DB375237/salvaduino/documents/solenoid-lock.png

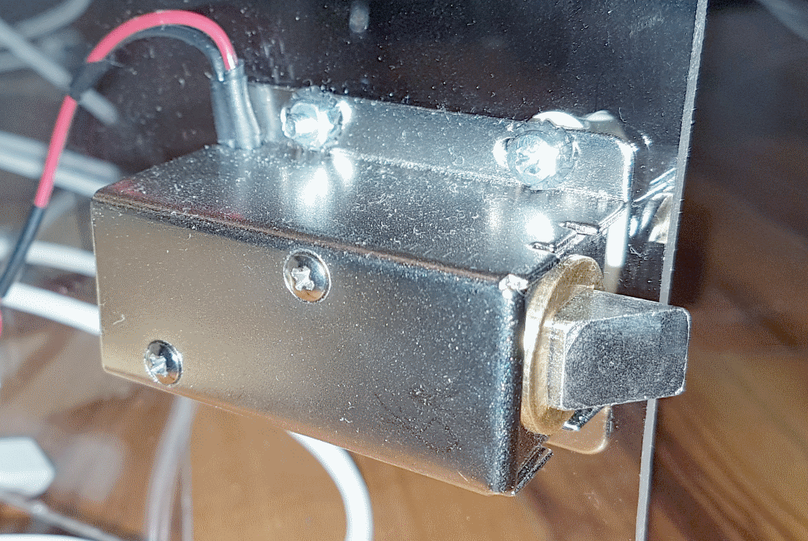
documents/solenoid-lock.png
