DB375237/salvaduino/documents/LCD.png

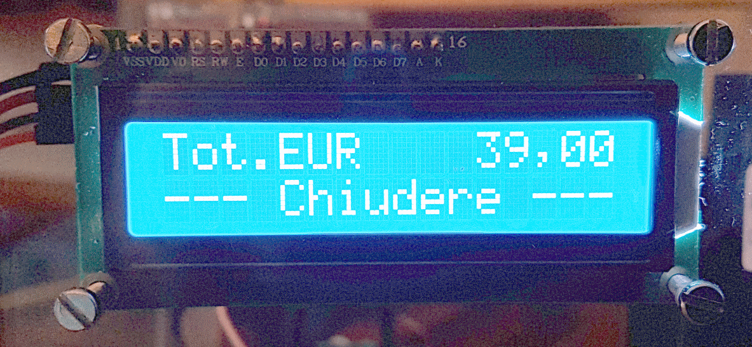
documents/LCD.png
