DB375237/salvaduino/documents/arduino.png

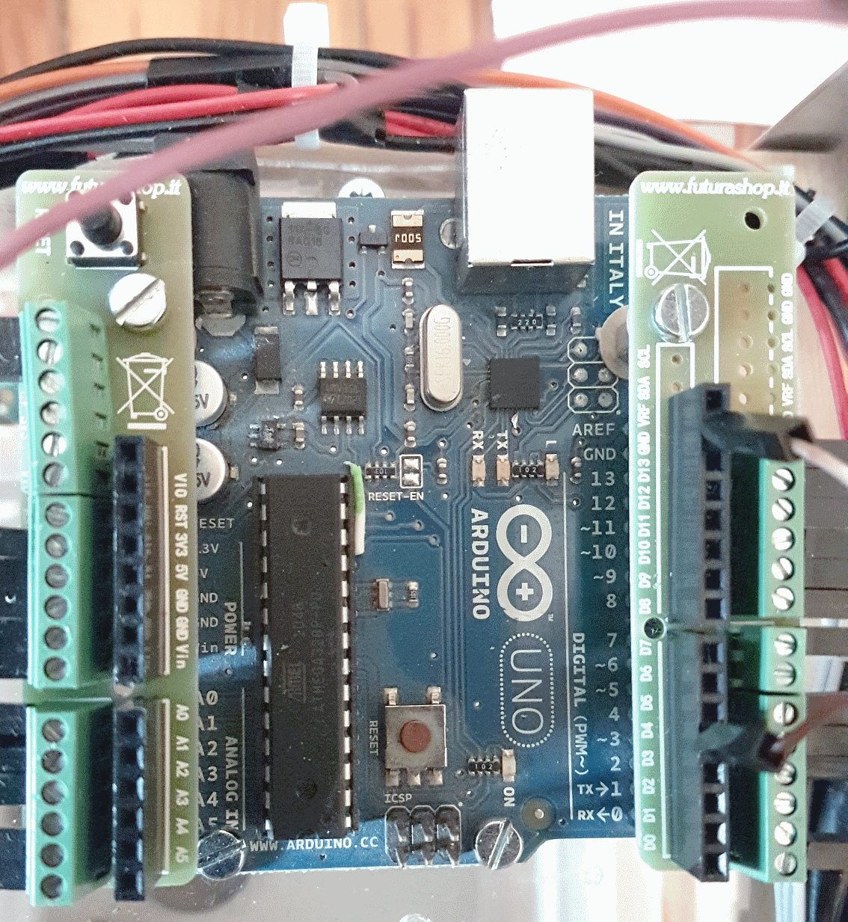
documents/arduino.png
