DB375237/salvaduino/documents/HC-SR04-2.png

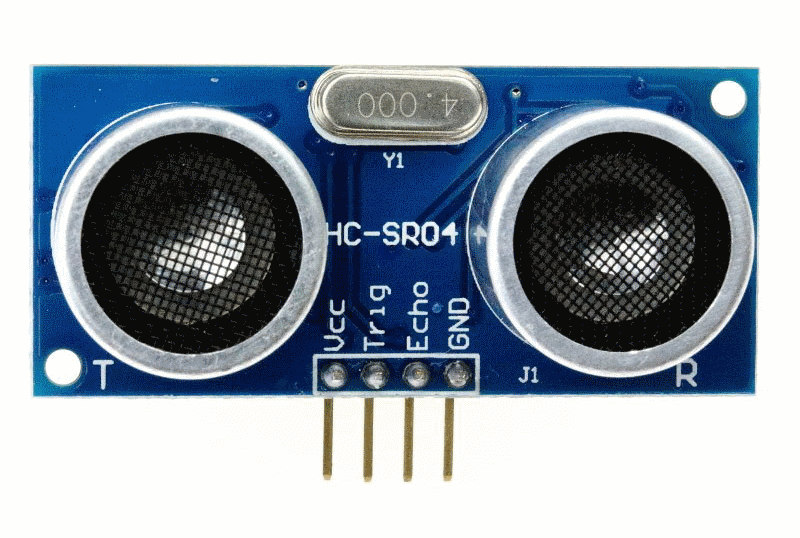
documents/HC-SR04-2.png
