DB375237/salvaduino/documents/HC-SR04.png

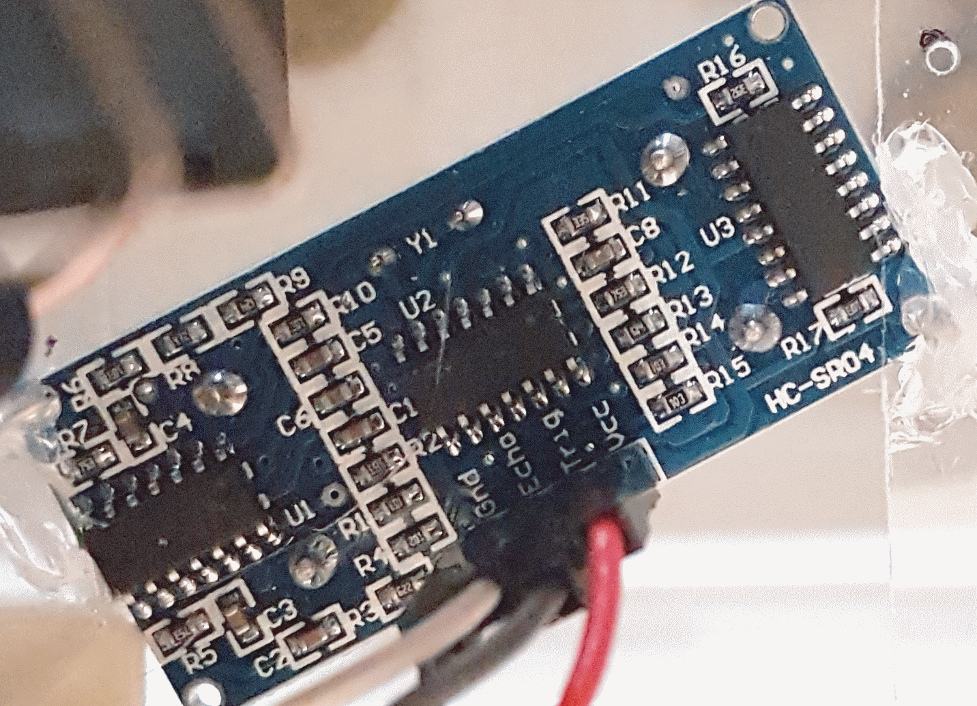
documents/HC-SR04.png
