DB375237/salvaduino/documents/I2C-backpack.png

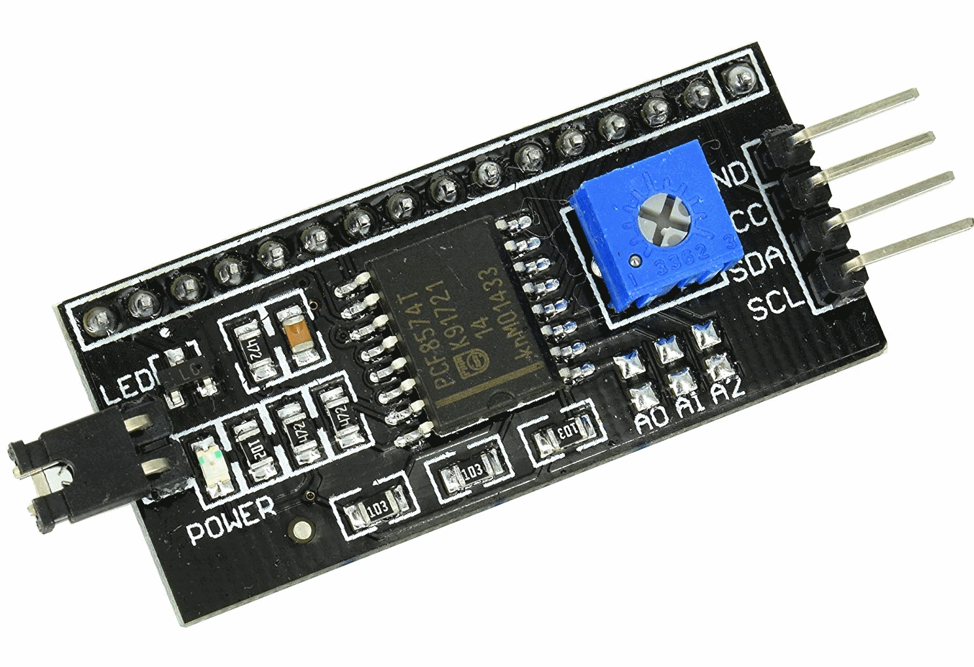
documents/I2C-backpack.png
