DB375237/salvaduino/documents/rfid.png

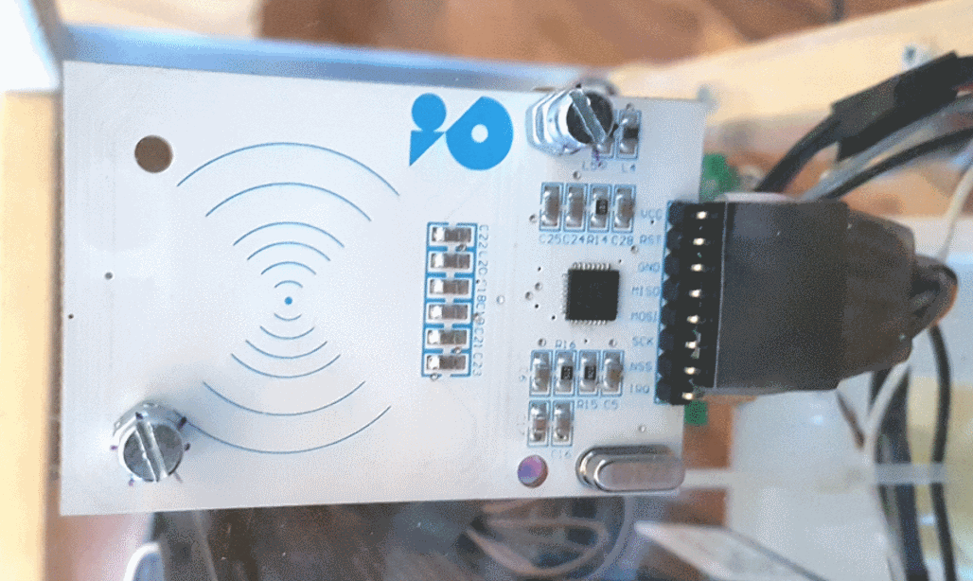
documents/rfid.png
