DB375237/salvaduino/documents/salvaduino-12-5-schematic.png

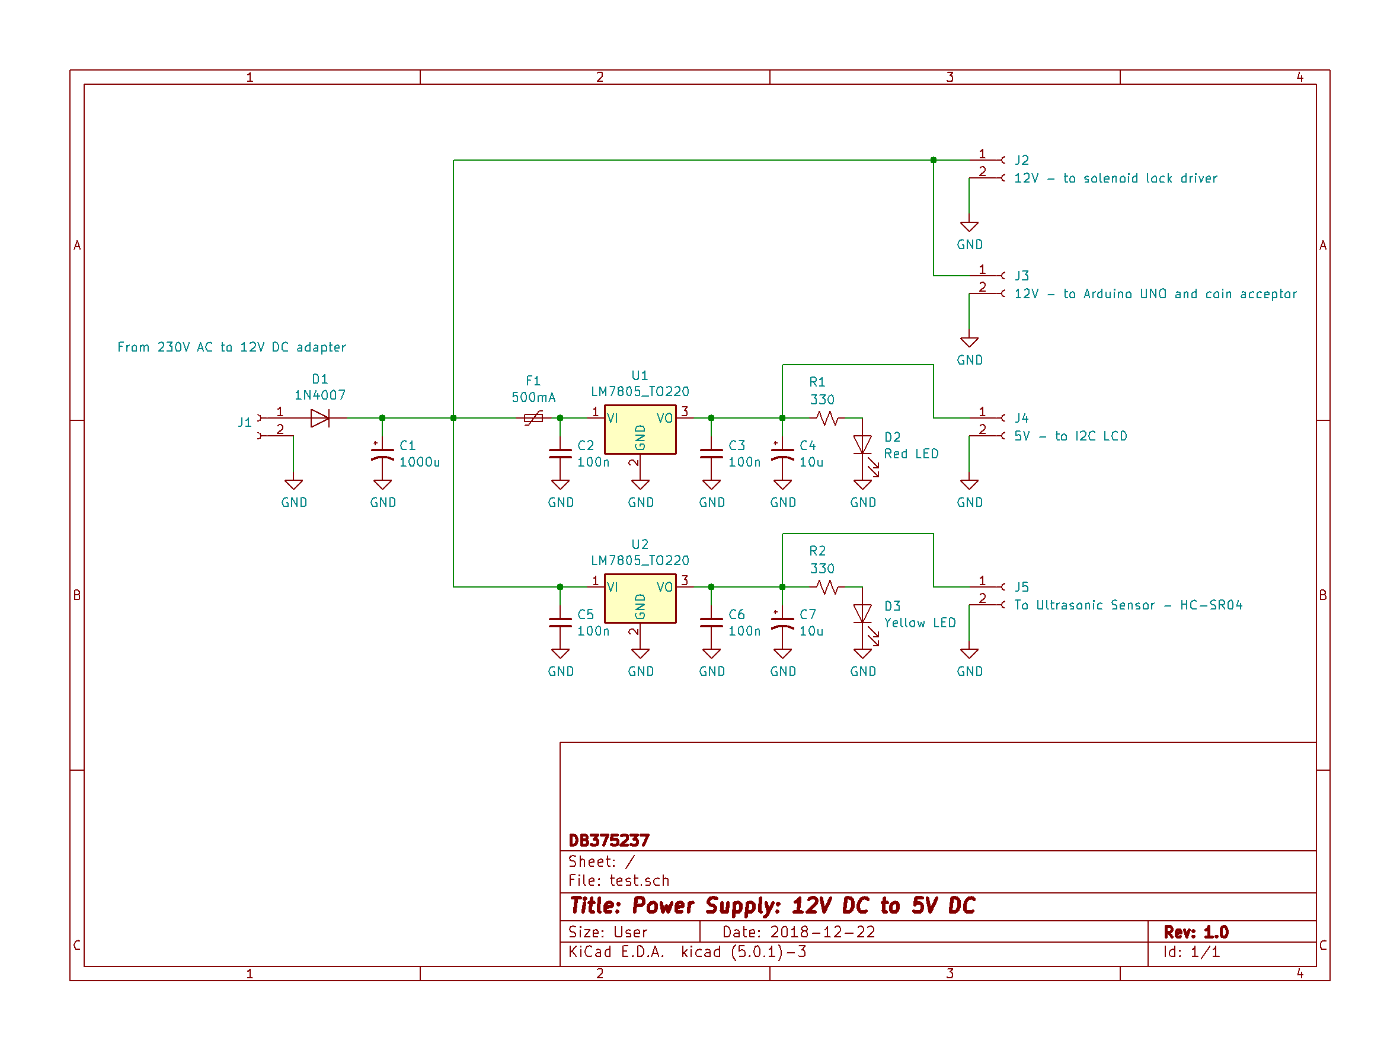
documents/salvaduino-12-5-schematic.png
