DB375237/salvaduino/documents/salvaduino-block-diagram.png

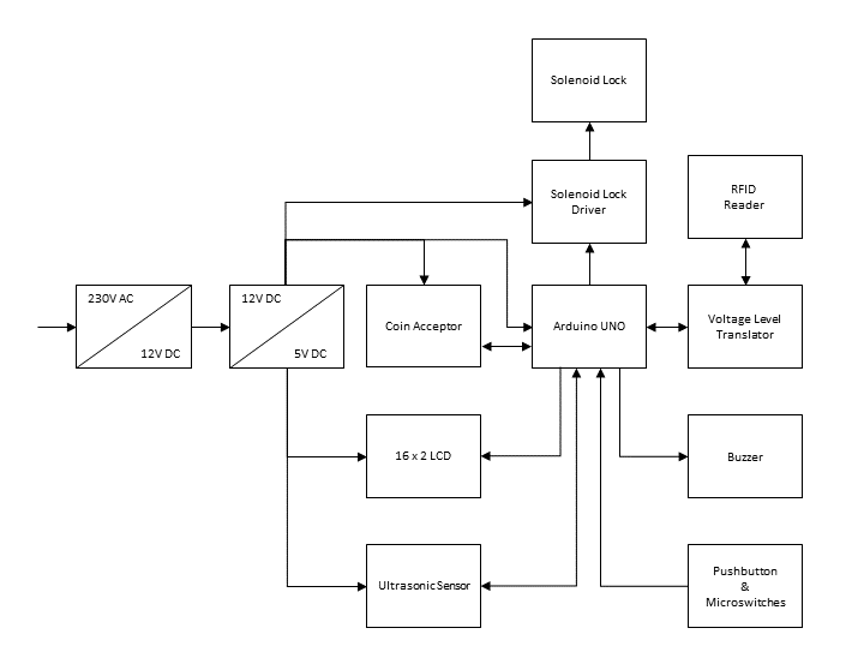
documents/salvaduino-block-diagram.png
