DB375237/salvaduino/documents/salvaduino-other-peripherals.png

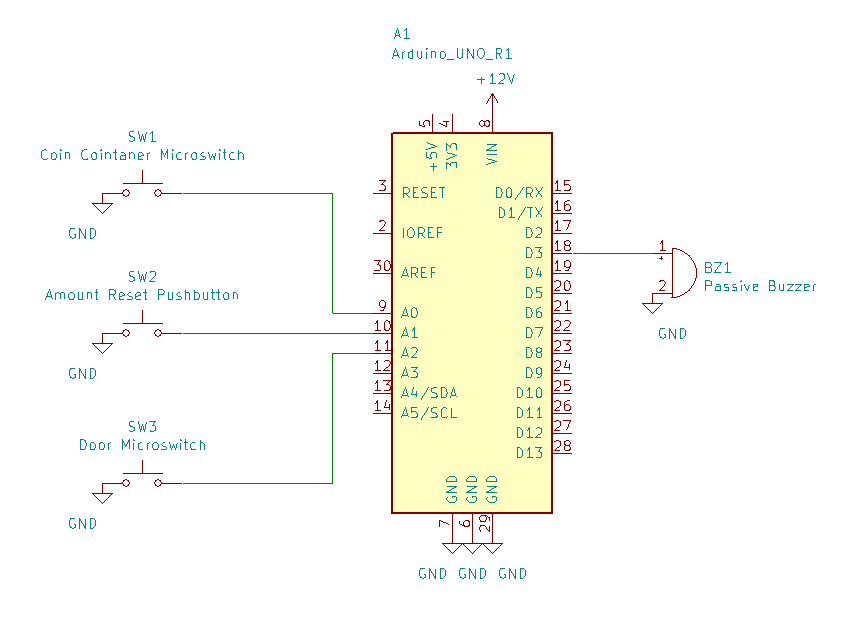
documents/salvaduino-other-peripherals.png
