DB375237/salvaduino/documents/salvaduino-rfid.png

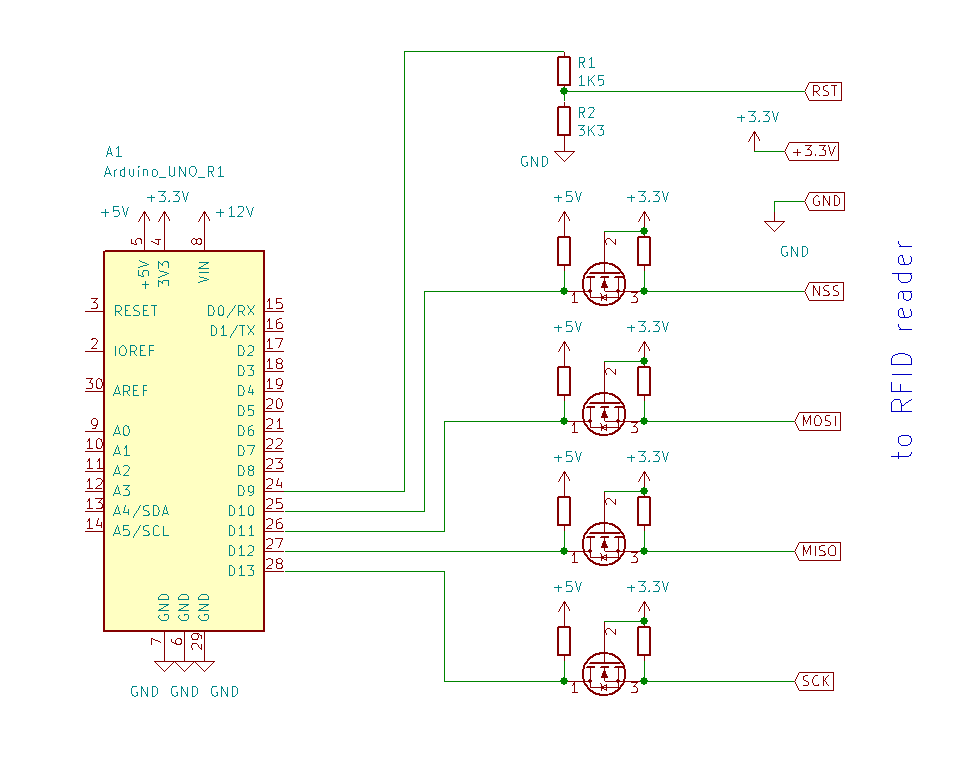
documents/salvaduino-rfid.png
