DB375237/salvaduino/documents/salvaduino-solenoid-driver-schematic.png

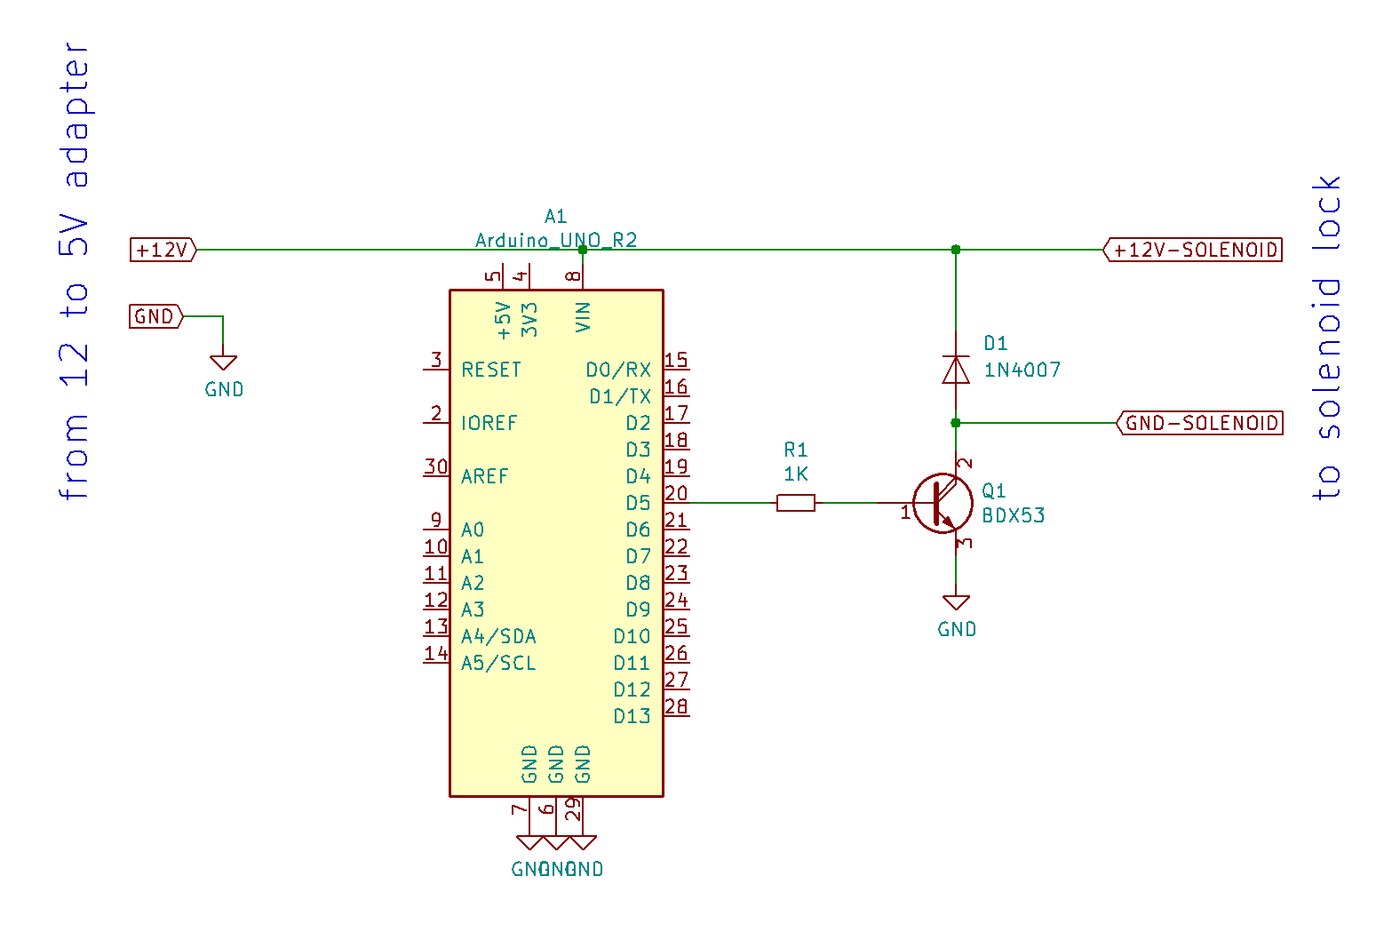
documents/salvaduino-solenoid-driver-schematic.png
