DB375237/salvaduino/documents/salvaduino-state.png

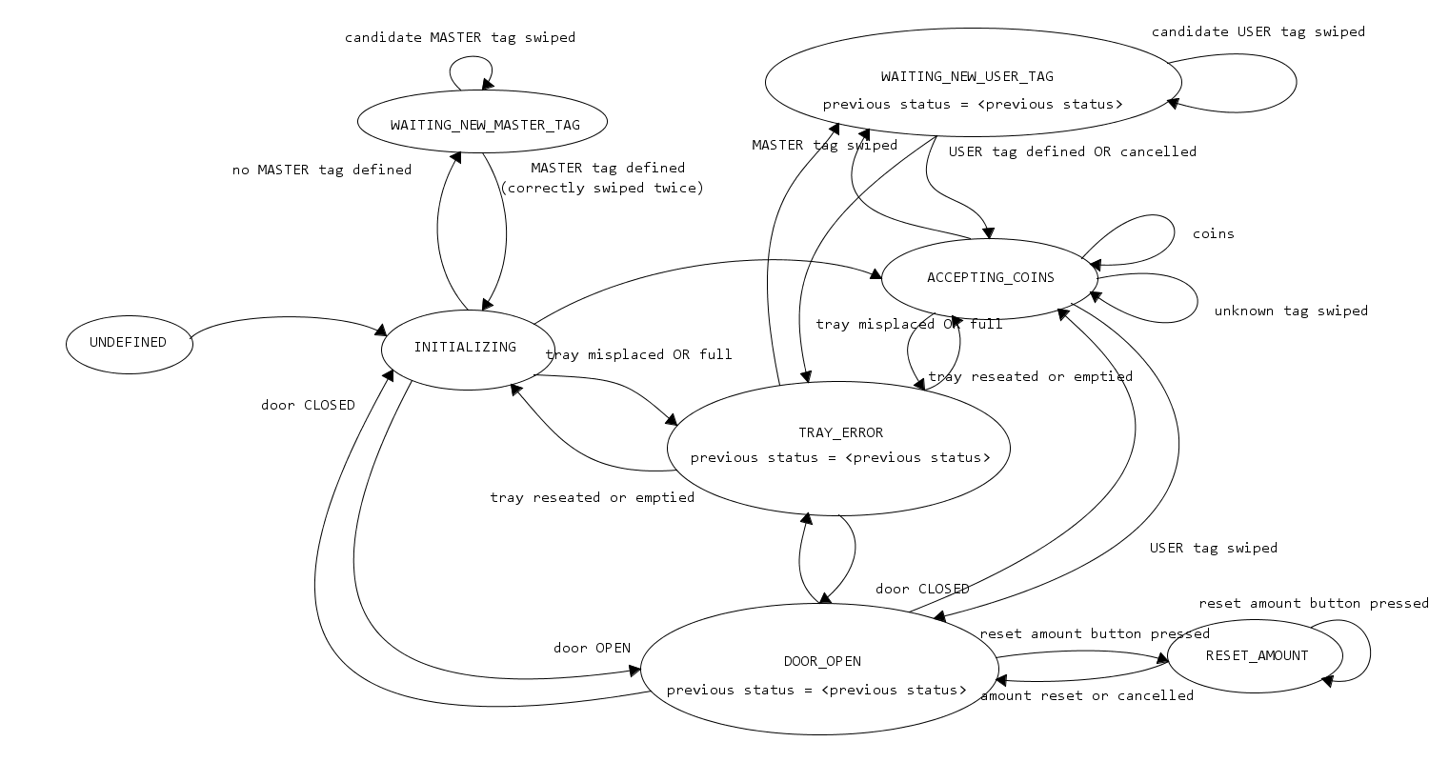
documents/salvaduino-state.png
