DB375237/salvaduino/documents/salvaduino.png

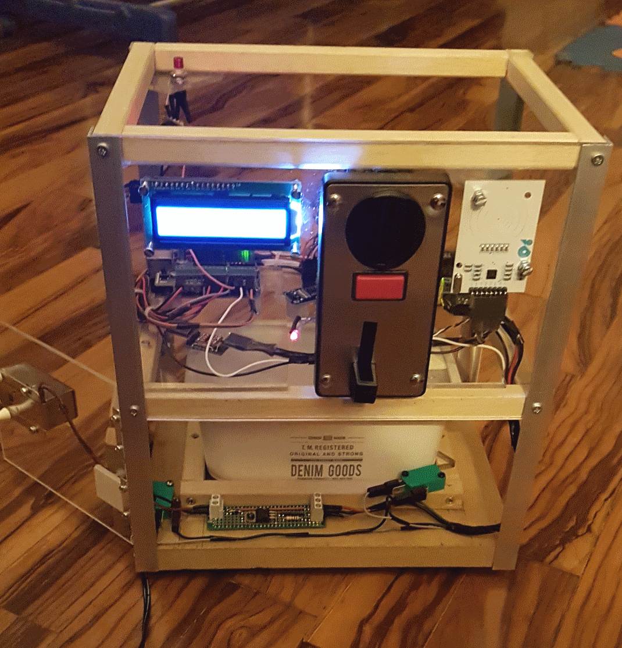
documents/salvaduino.png
