DB375237/salvaduino/documents/solenoid-lock-driver.png

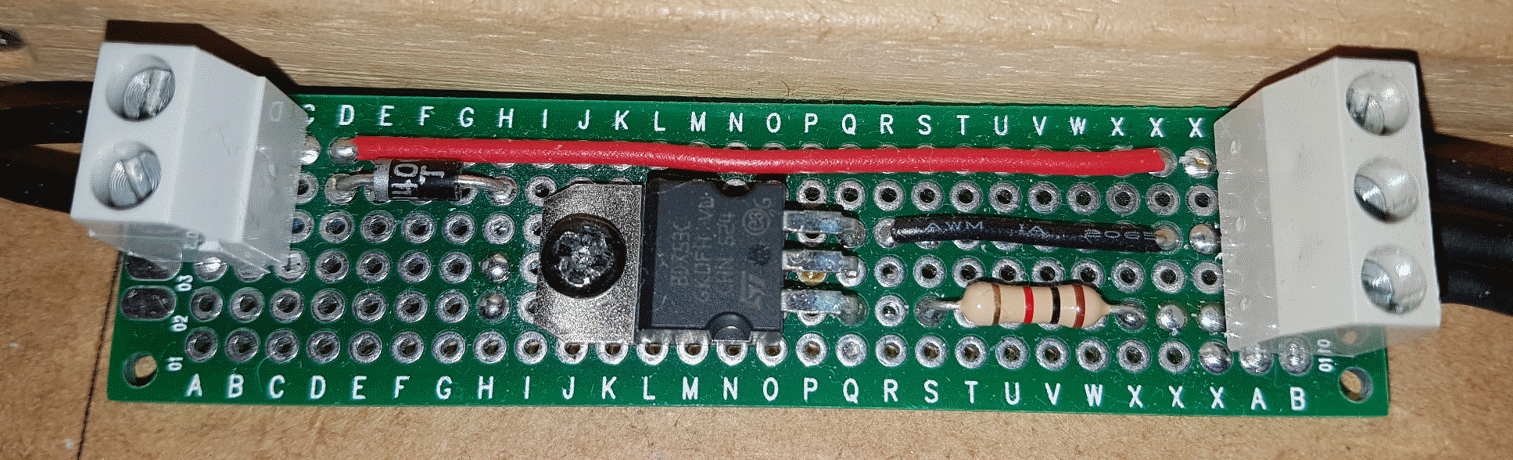
documents/solenoid-lock-driver.png
