DB375237/salvaduino/documents/voltage-level-translator.png

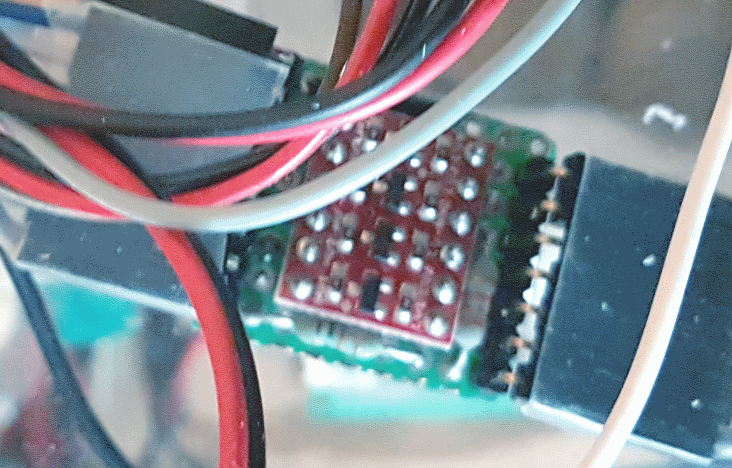
documents/voltage-level-translator.png
