DB375237/salvaduino/documents/coin-acceptor-wiring.png

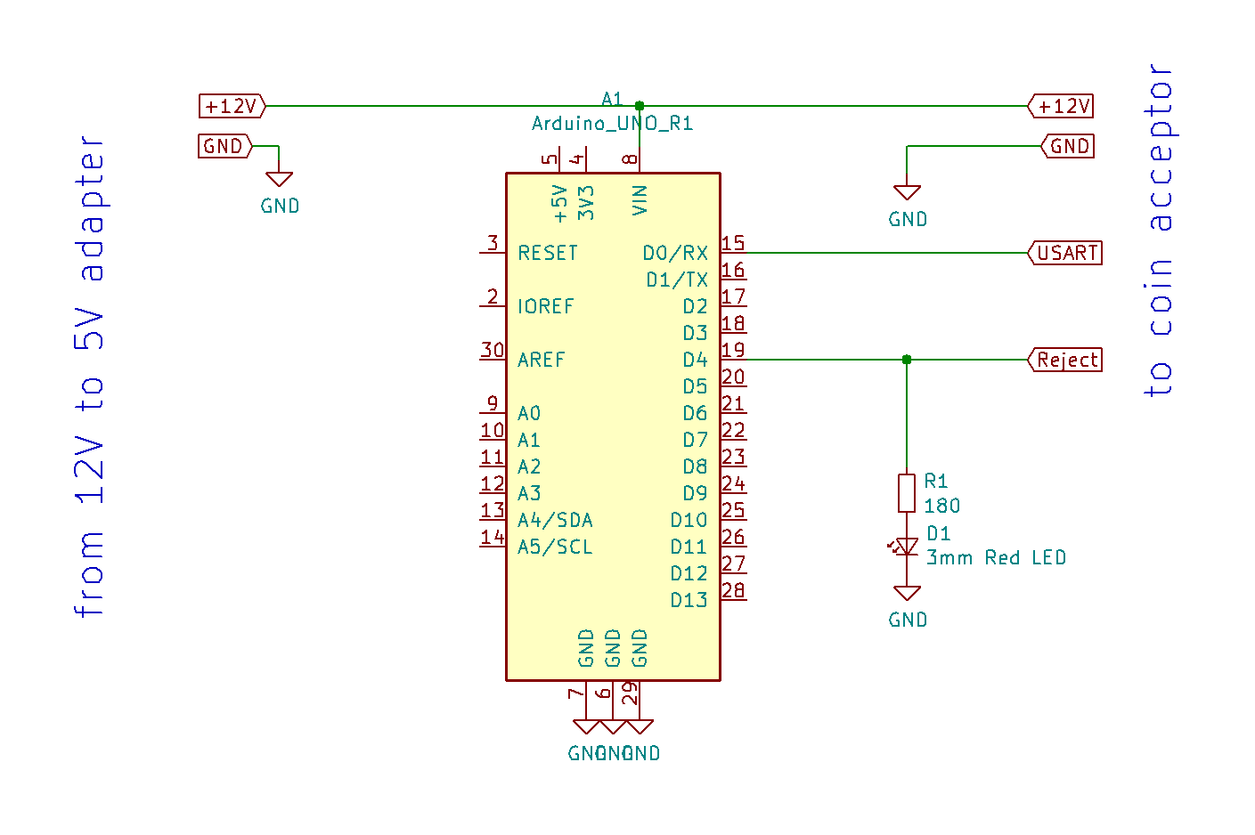
documents/coin-acceptor-wiring.png
