DB375237/salvaduino/documents/lock_style_solenoid.pdf

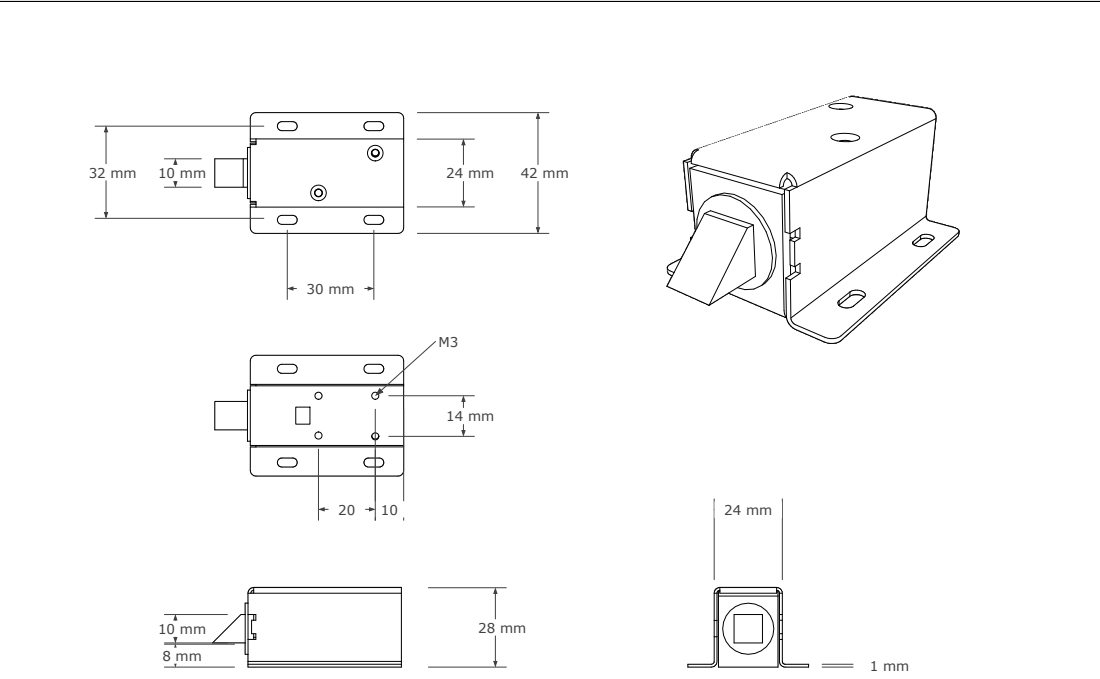
[picture p18: page 1]
